Dillon17-Kage/smart-water/docs/README.md

# Docs

Design notes, test records and calibration results for the technical report.
