Dillon17-Kage/smart-water/docs/screenshots/01-login.png

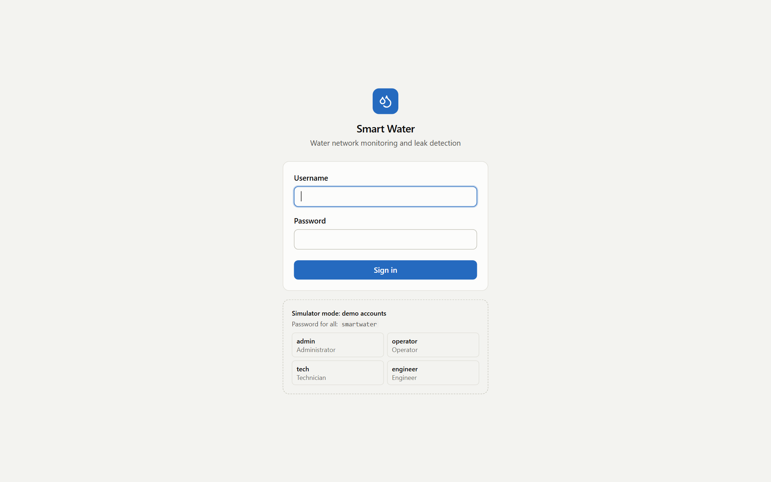
docs/screenshots/01-login.png
