Dillon17-Kage/smart-water/docs/screenshots/03-dashboard-normal.png

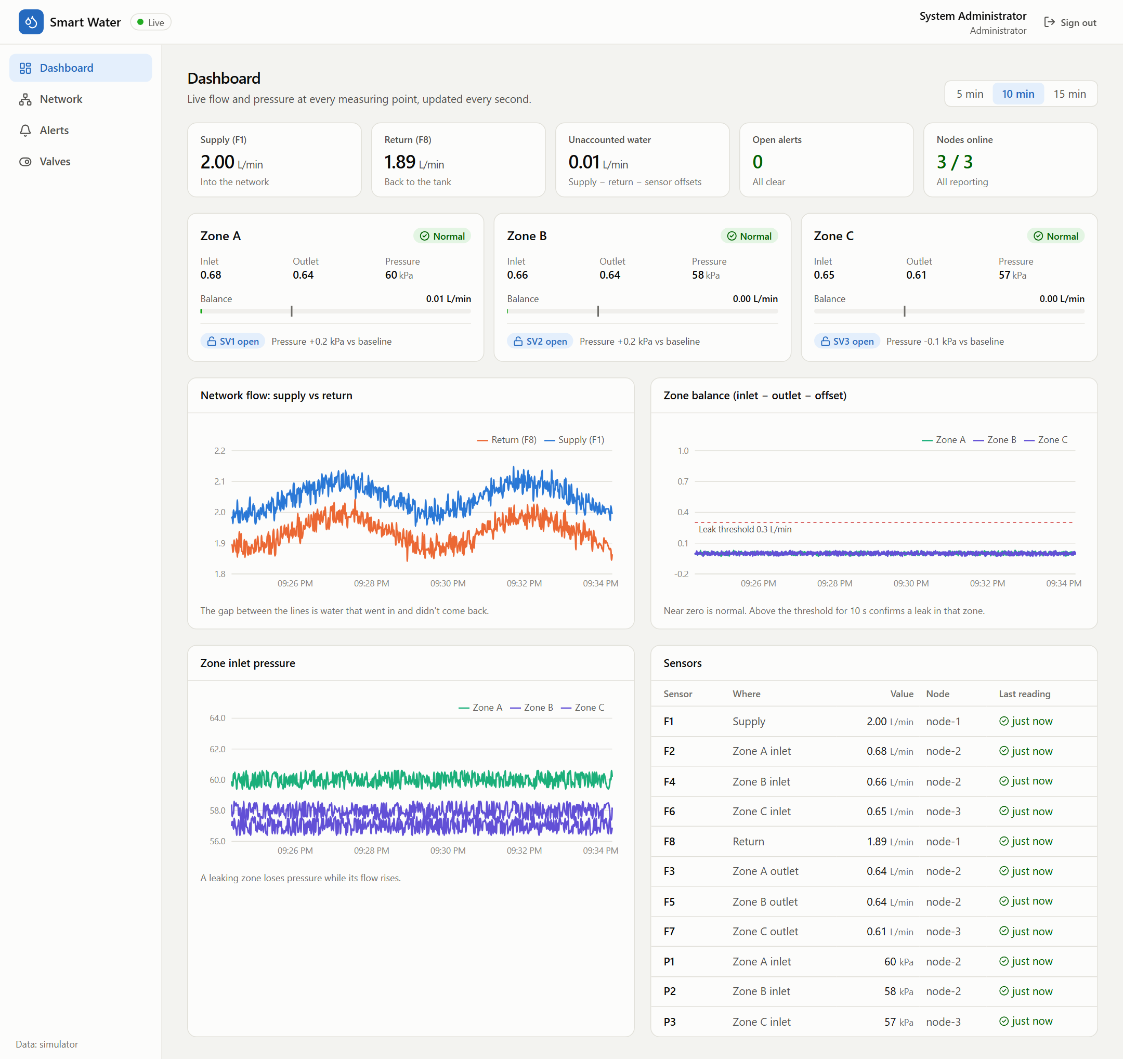
docs/screenshots/03-dashboard-normal.png
