Dillon17-Kage/smart-water/docs/screenshots/05-valves-normal.png

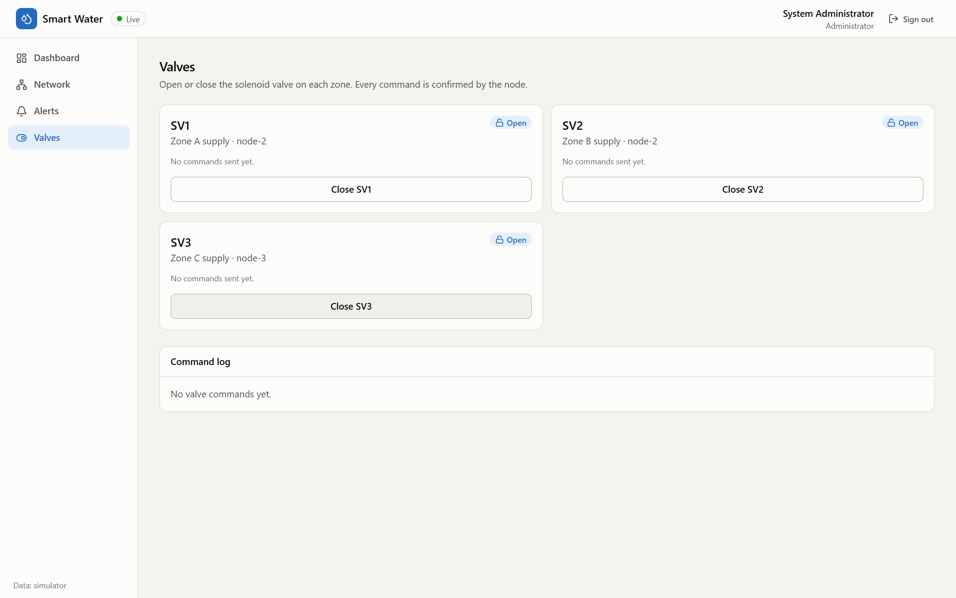
docs/screenshots/05-valves-normal.png
