Dillon17-Kage/smart-water/docs/screenshots/06-alerts-none.png

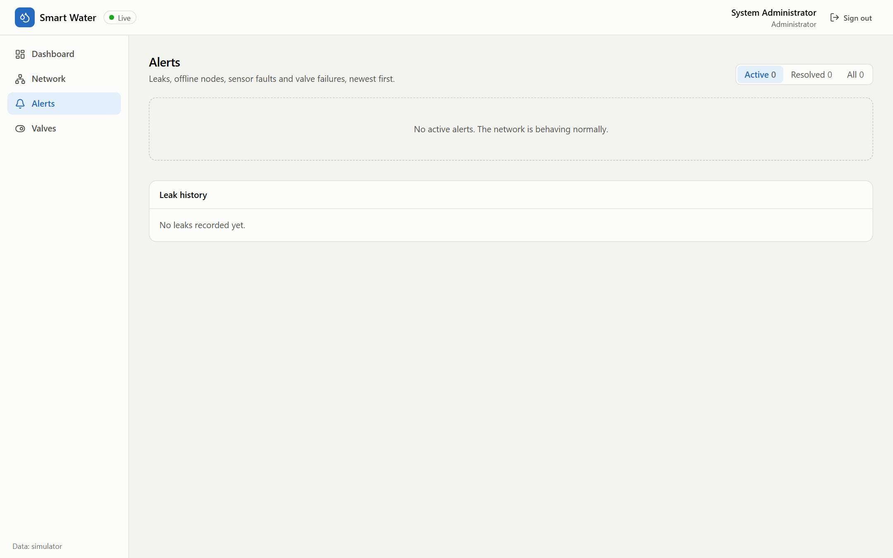
docs/screenshots/06-alerts-none.png
