Dillon17-Kage/smart-water/docs/screenshots/07-dashboard-leak-suspected.png

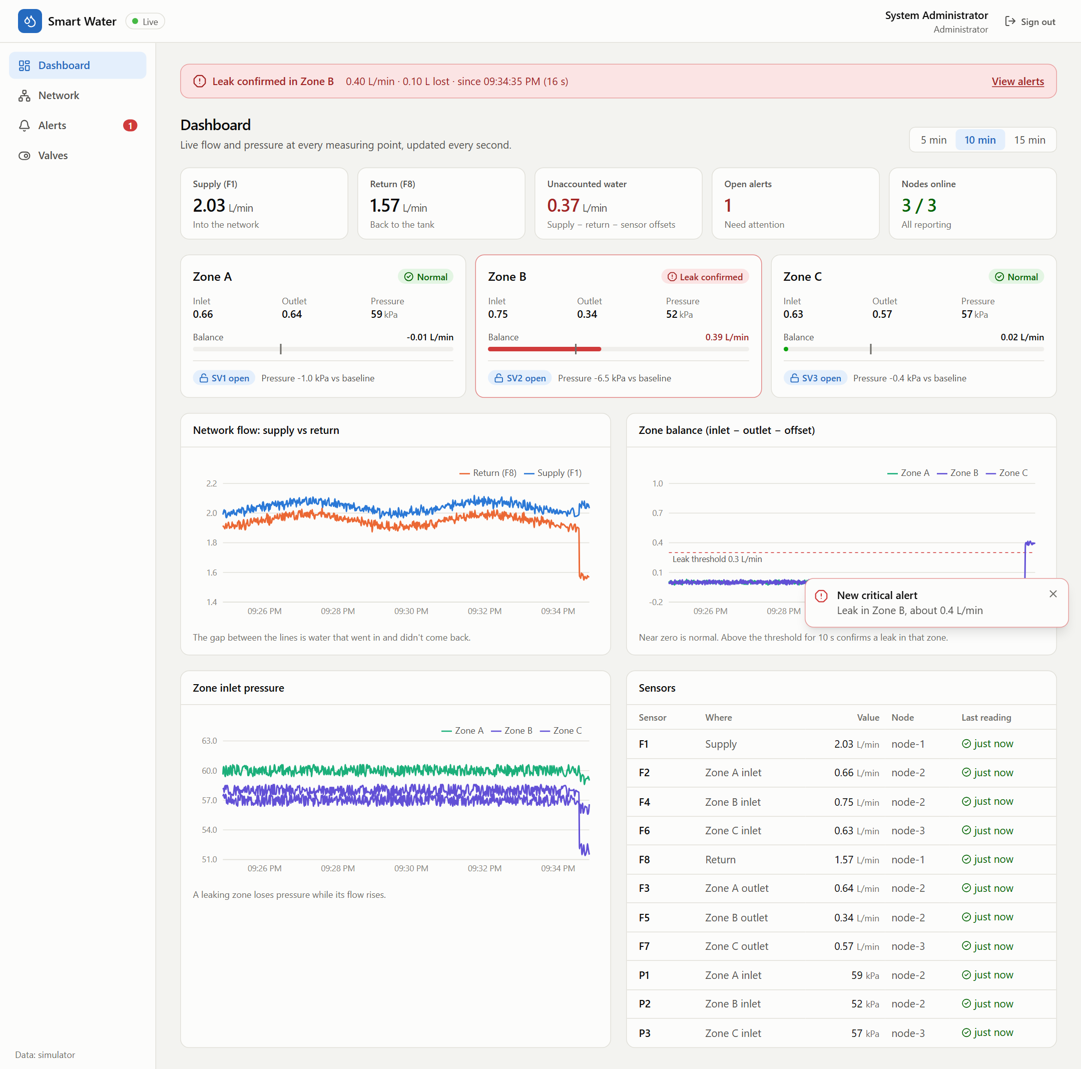
docs/screenshots/07-dashboard-leak-suspected.png
