Dillon17-Kage/smart-water/docs/screenshots/08-dashboard-leak-confirmed.png

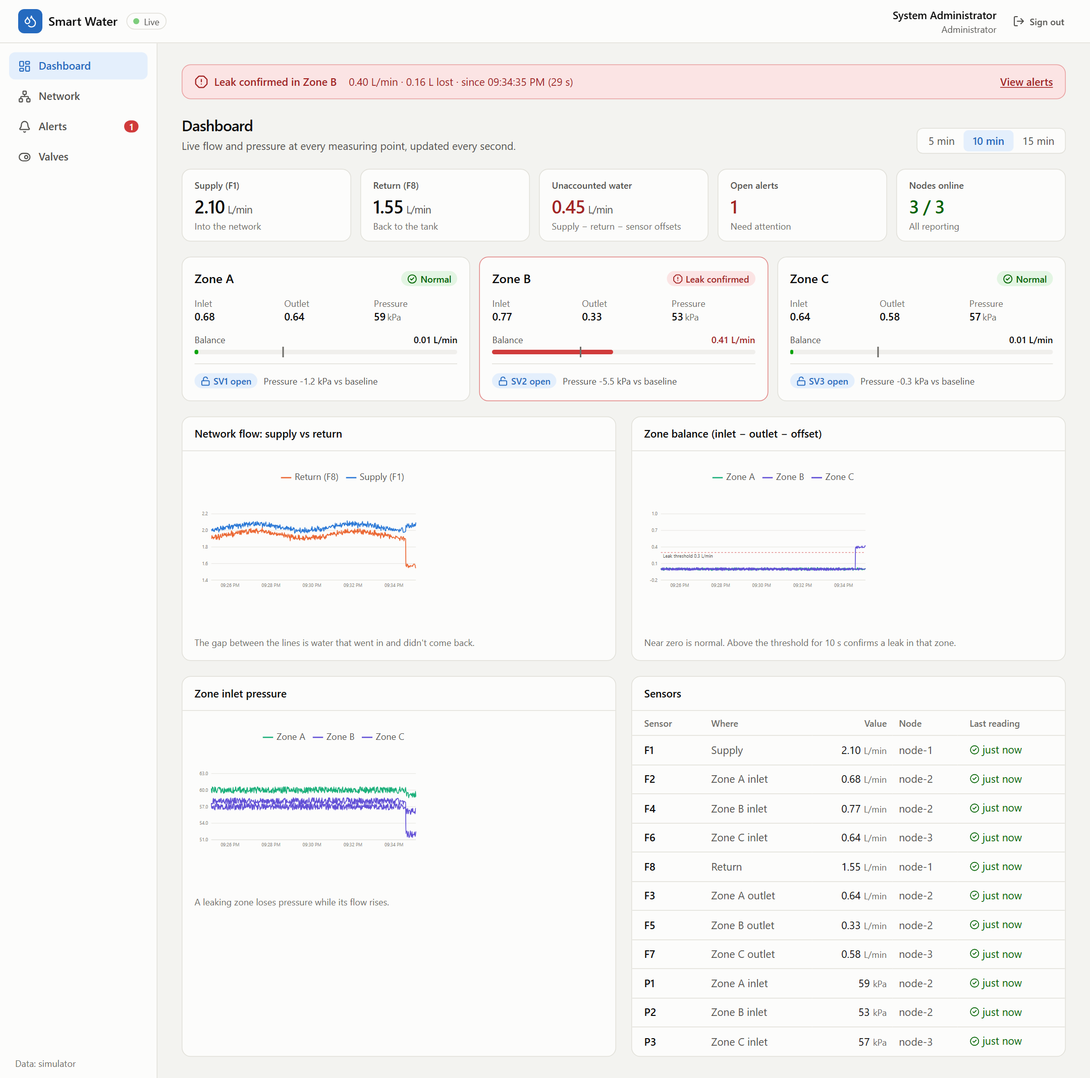
docs/screenshots/08-dashboard-leak-confirmed.png
