Dillon17-Kage/smart-water/docs/screenshots/09-network-leak.png

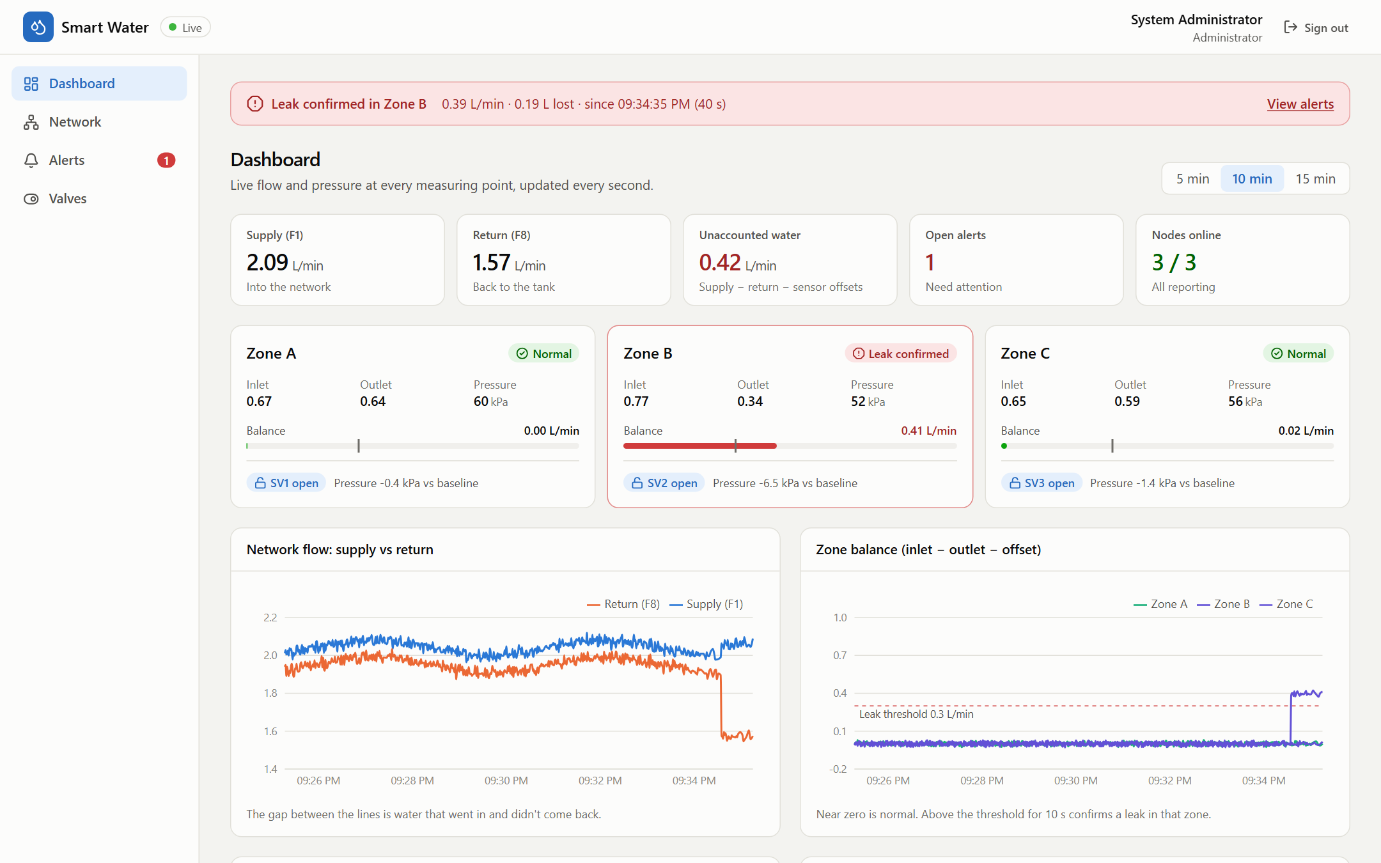
docs/screenshots/09-network-leak.png
