Dillon17-Kage/smart-water/docs/screenshots/10-alerts-leak.png

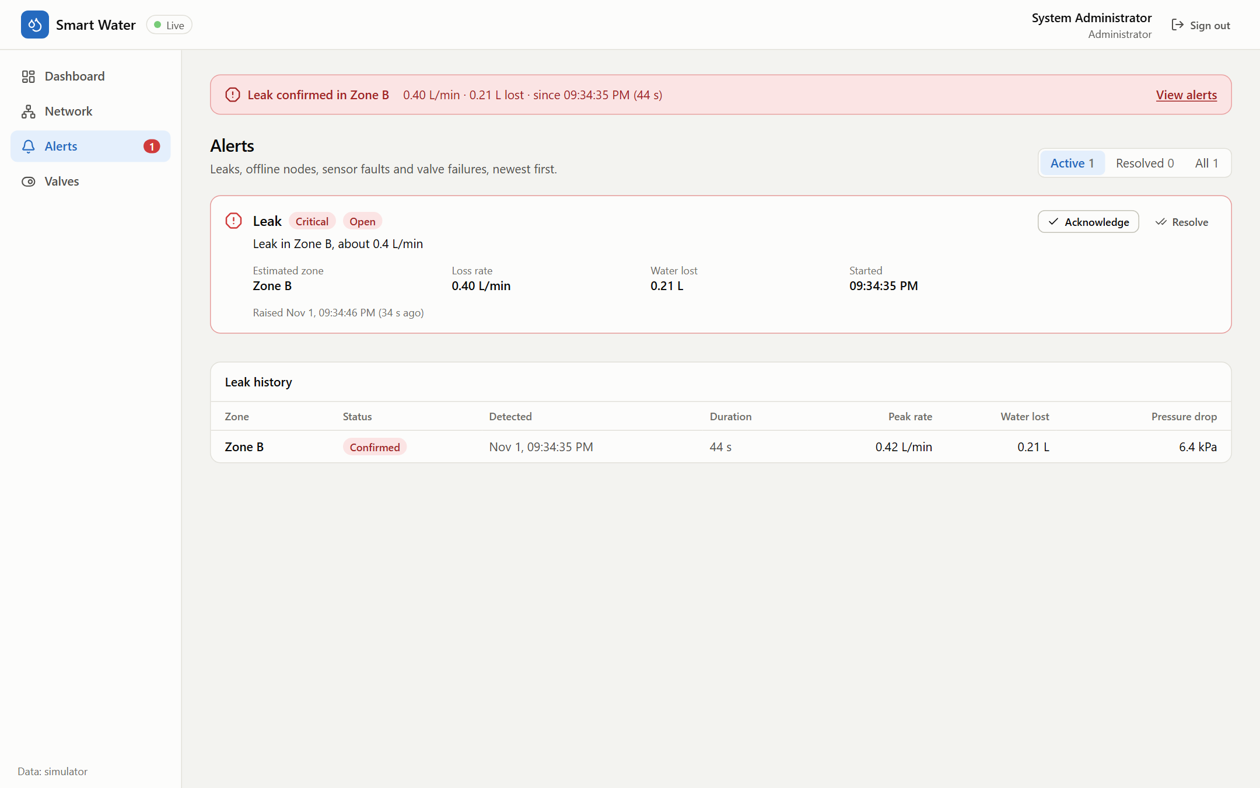
docs/screenshots/10-alerts-leak.png
