Dillon17-Kage/smart-water/docs/screenshots/11-valve-close-dialog.png

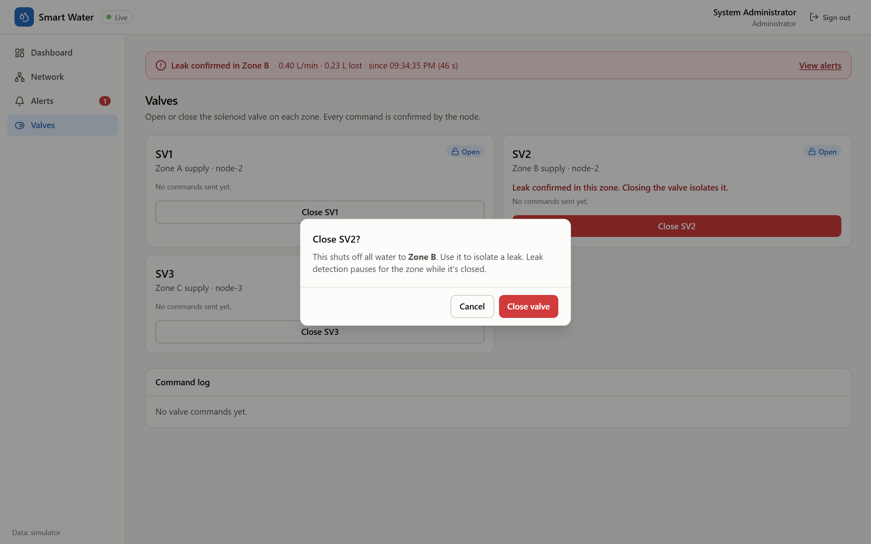
docs/screenshots/11-valve-close-dialog.png
