Dillon17-Kage/smart-water/docs/screenshots/12-valve-close-sent.png

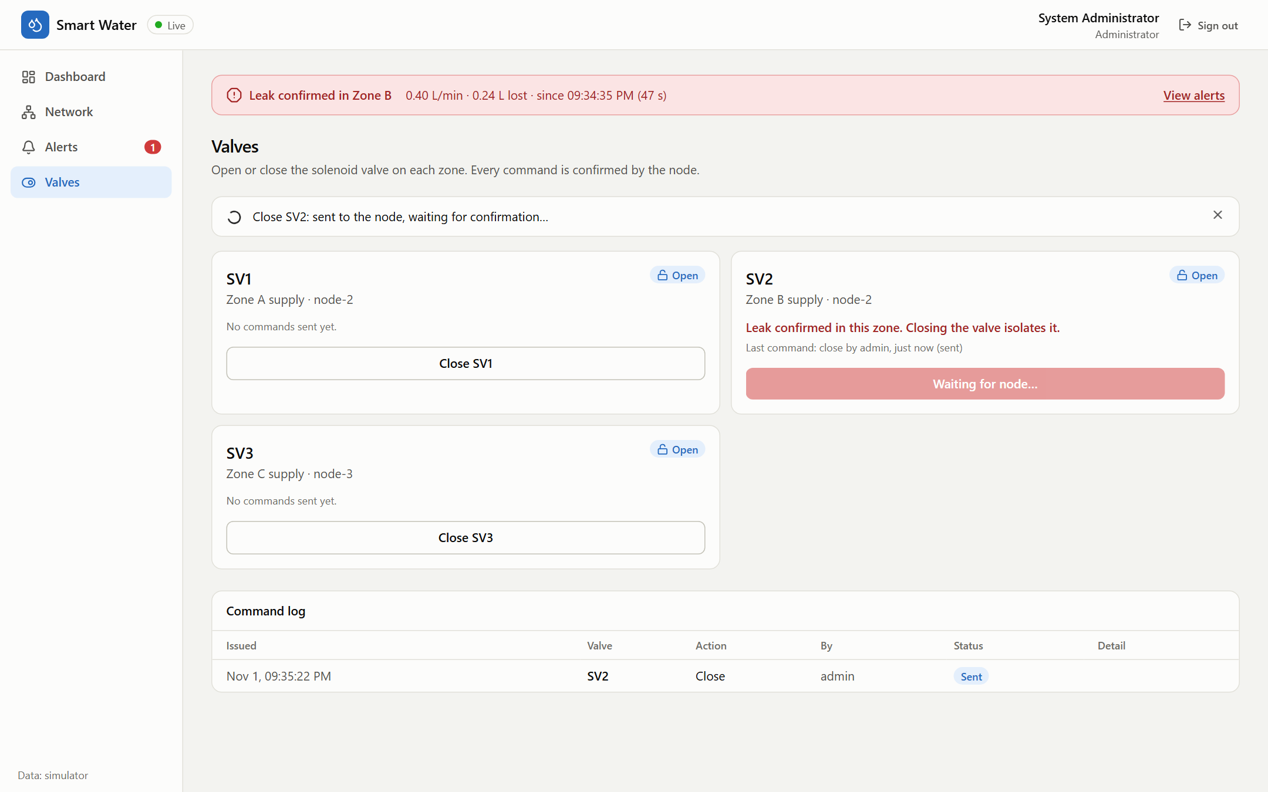
docs/screenshots/12-valve-close-sent.png
