Dillon17-Kage/smart-water/docs/screenshots/13-valve-close-confirmed.png

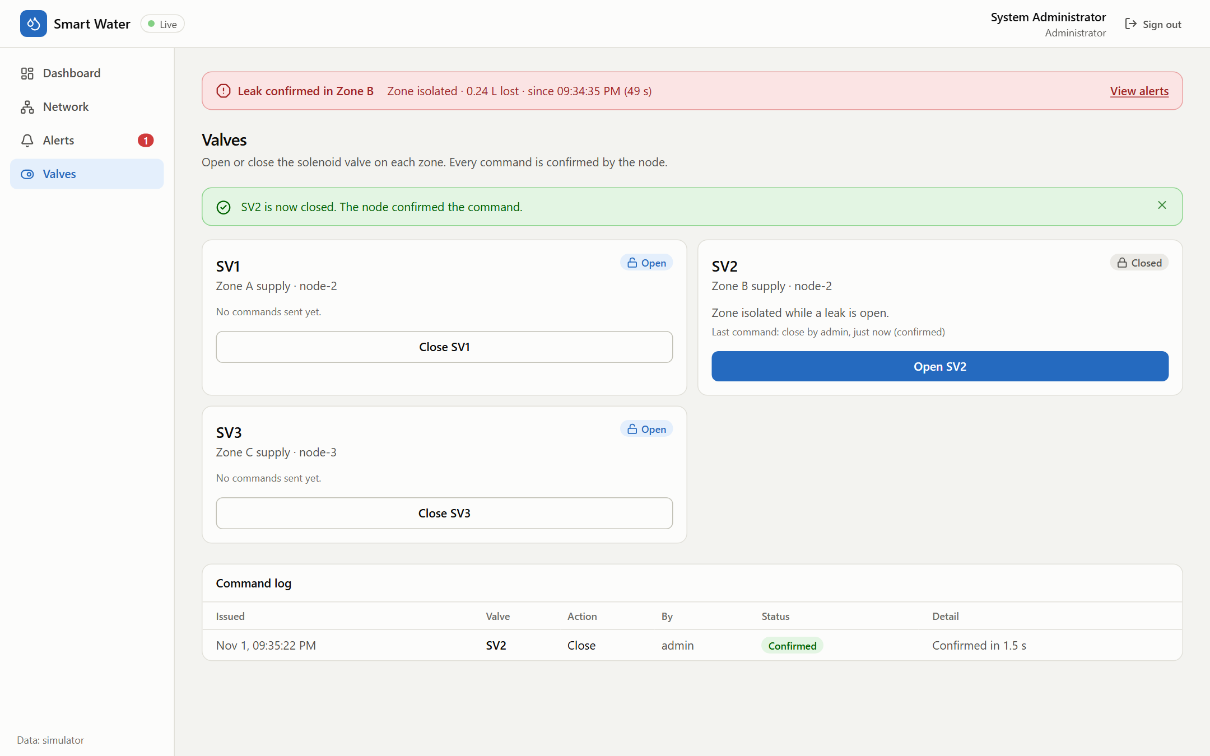
docs/screenshots/13-valve-close-confirmed.png
