Dillon17-Kage/smart-water/docs/screenshots/14-dashboard-zone-isolated.png

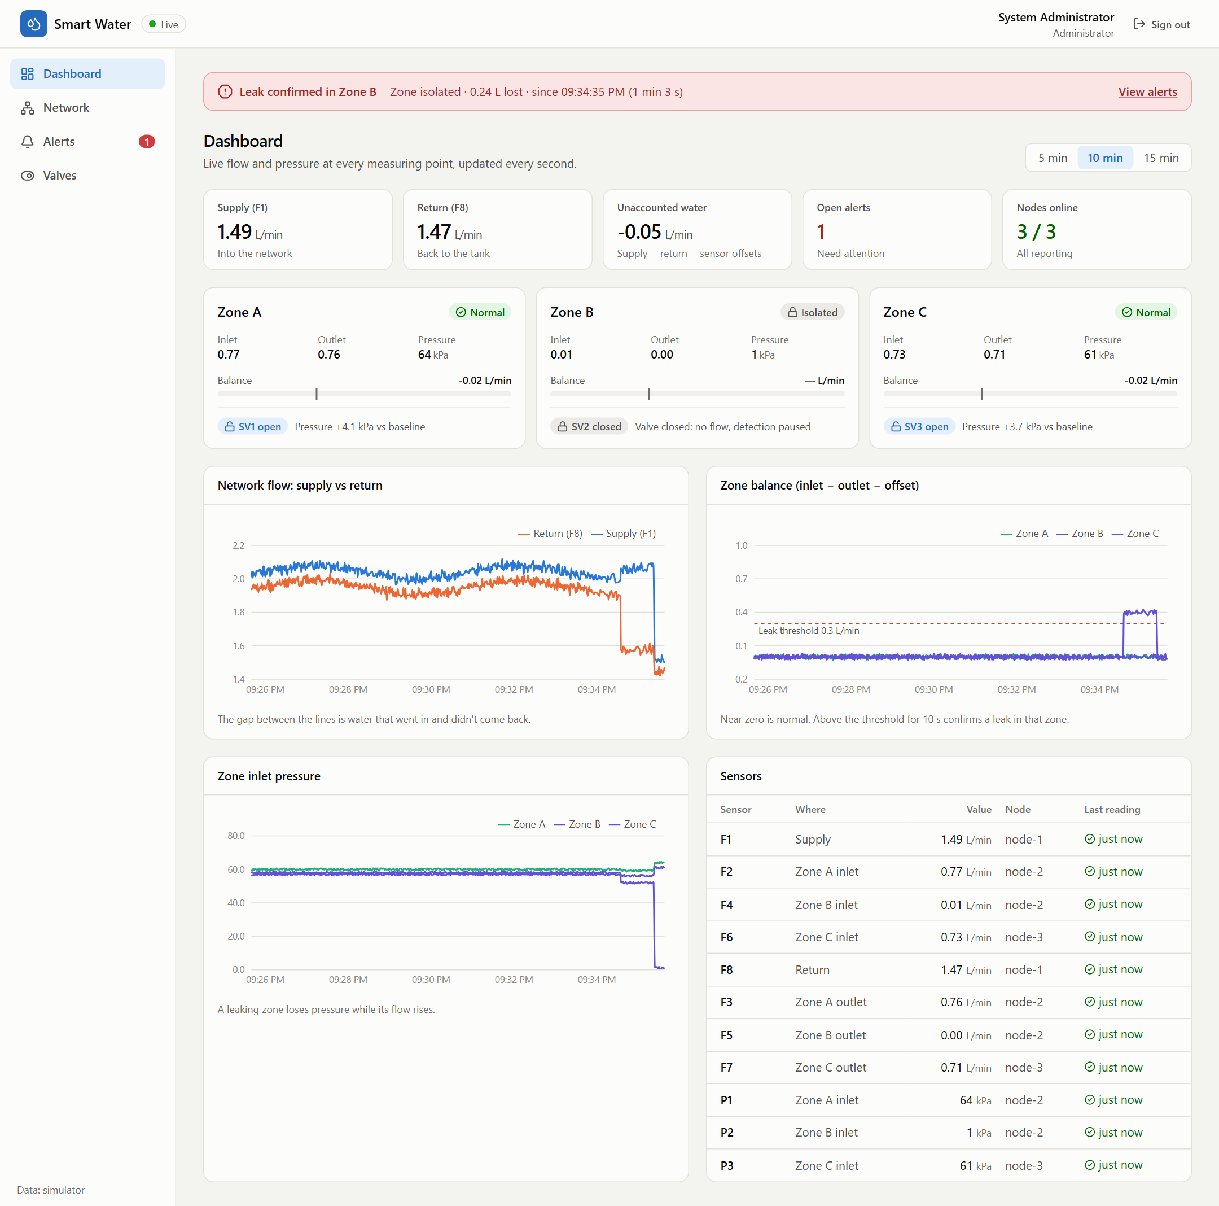
docs/screenshots/14-dashboard-zone-isolated.png
