Dillon17-Kage/smart-water/docs/screenshots/15-network-zone-isolated.png

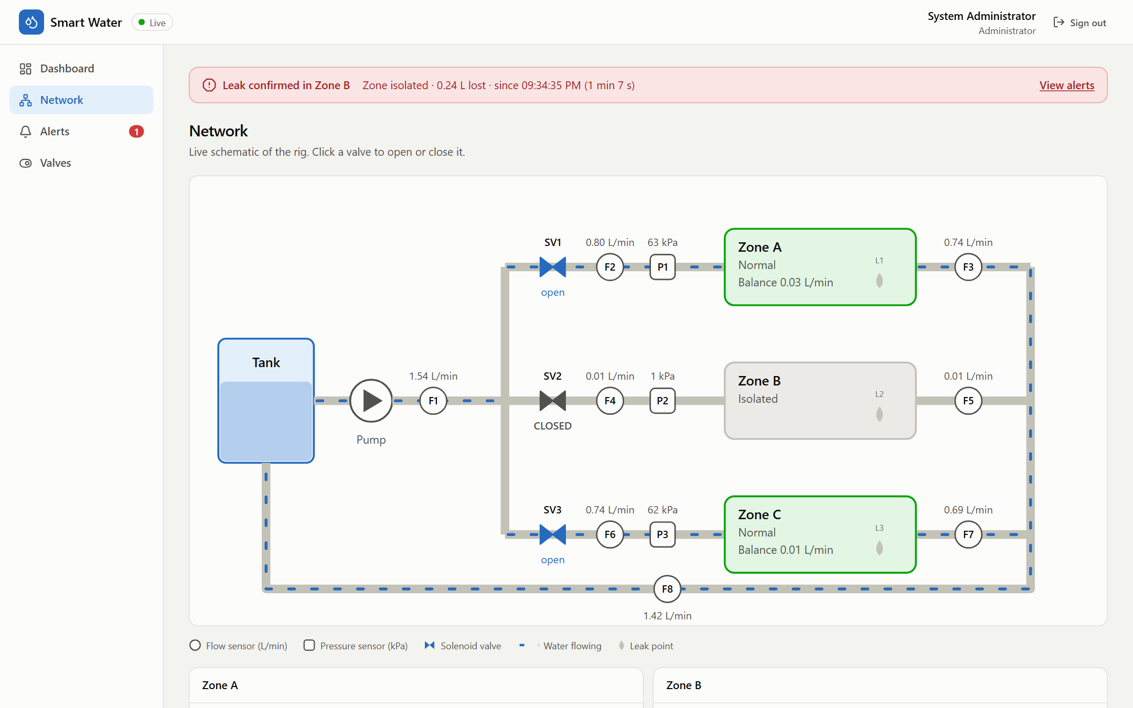
docs/screenshots/15-network-zone-isolated.png
