Dillon17-Kage/smart-water/docs/screenshots/16-alerts-acknowledged.png

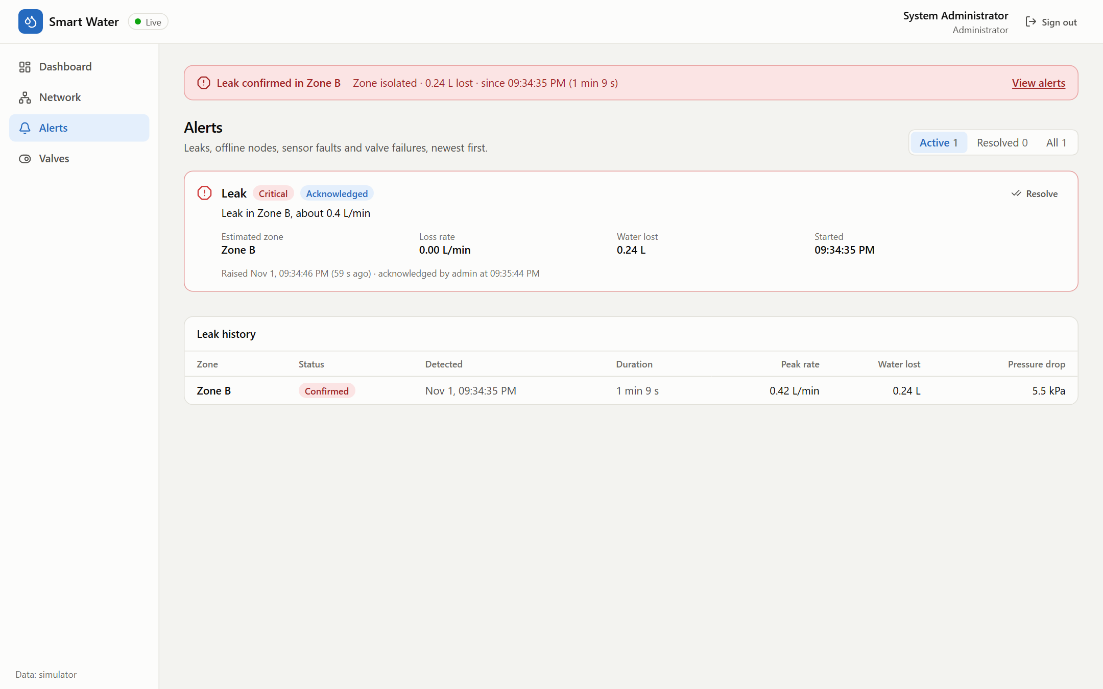
docs/screenshots/16-alerts-acknowledged.png
