Dillon17-Kage/smart-water/docs/screenshots/18-valve-last-zone-pump-off-check.png

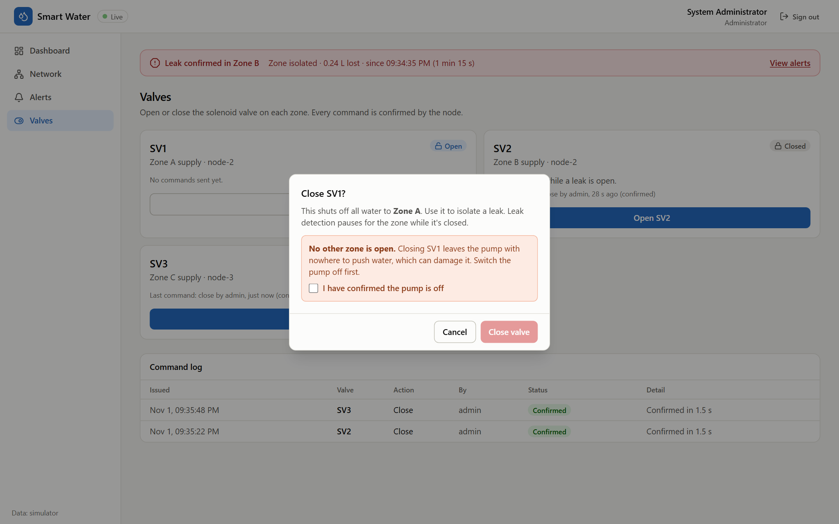
docs/screenshots/18-valve-last-zone-pump-off-check.png
