Dillon17-Kage/smart-water/docs/screenshots/20-dashboard-node-offline.png

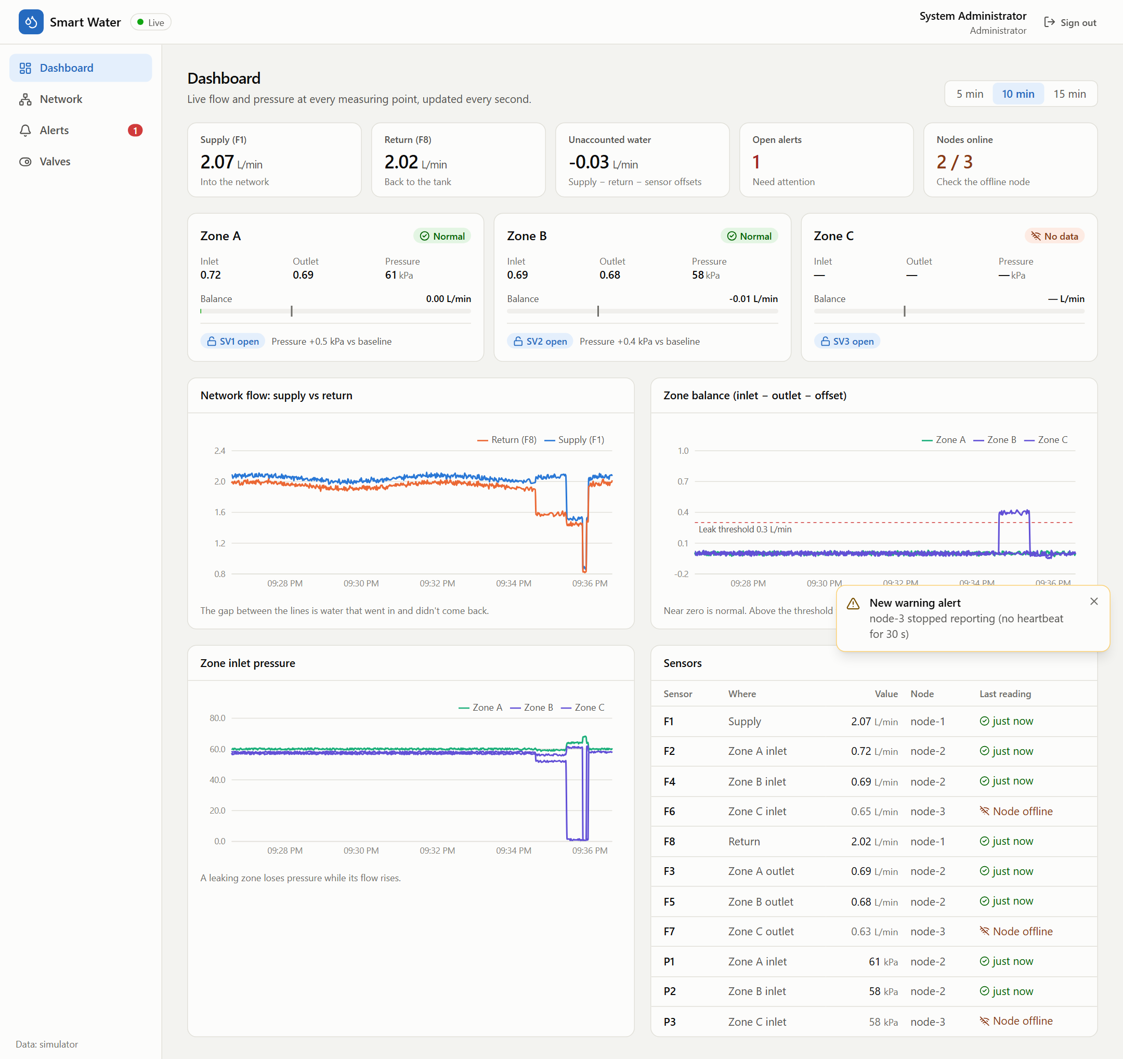
docs/screenshots/20-dashboard-node-offline.png
