Dillon17-Kage/smart-water/docs/screenshots/21-network-node-offline.png

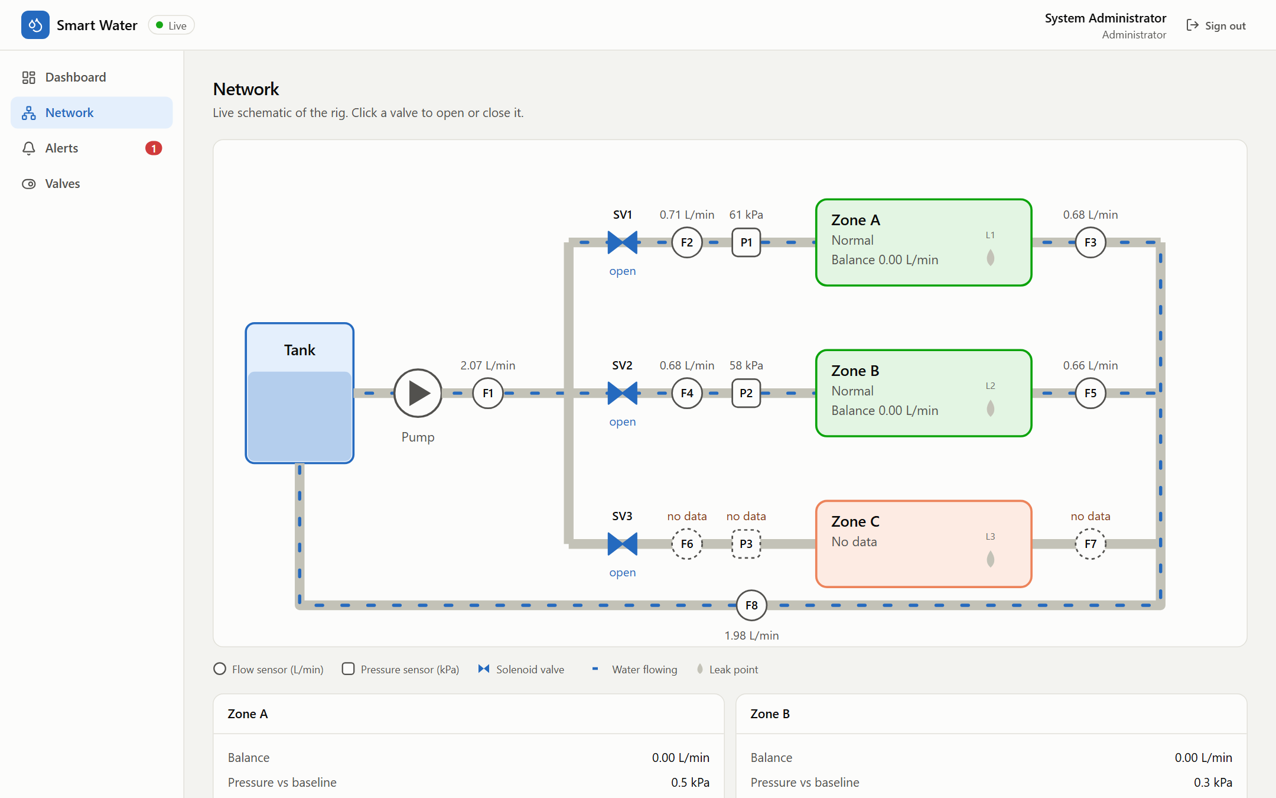
docs/screenshots/21-network-node-offline.png
