Dillon17-Kage/smart-water/docs/screenshots/22-alerts-node-offline.png

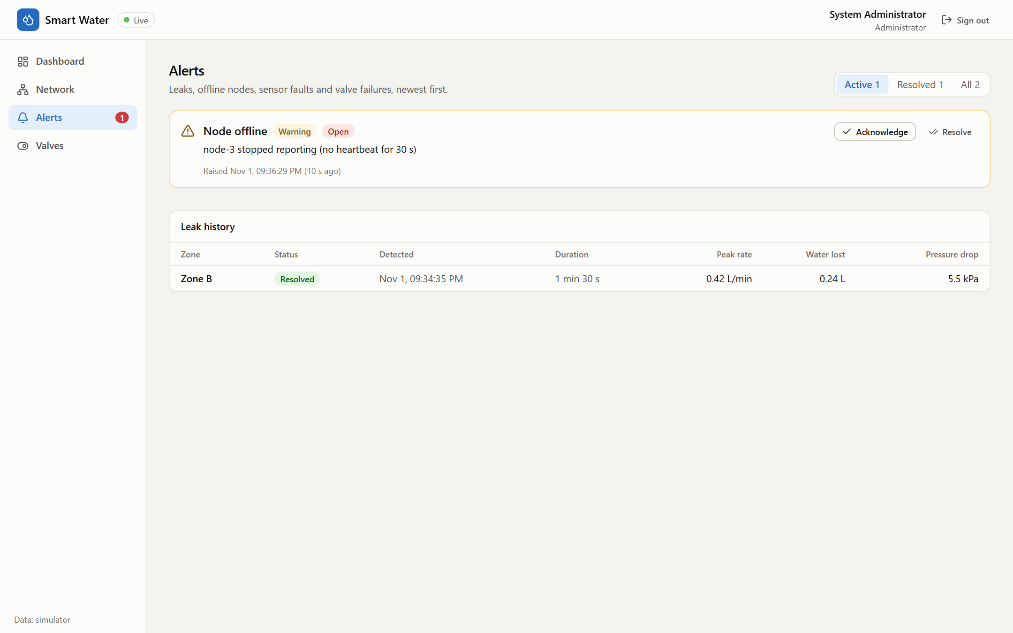
docs/screenshots/22-alerts-node-offline.png
