Dillon17-Kage/smart-water/docs/screenshots/23-dashboard-15-min-chart.png

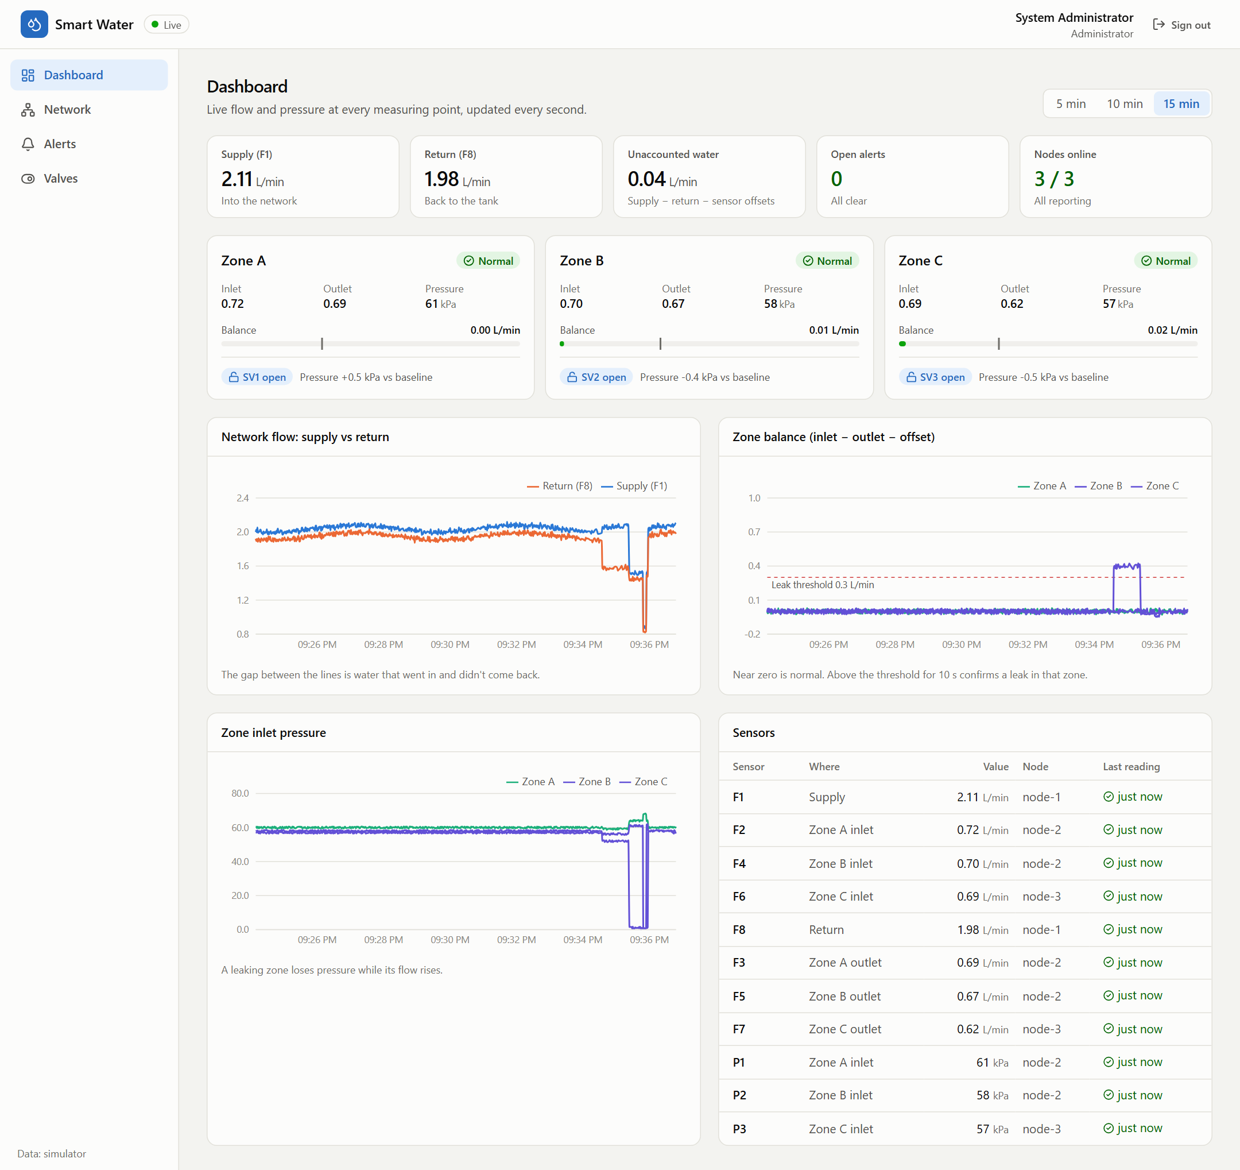
docs/screenshots/23-dashboard-15-min-chart.png
