Dillon17-Kage/smart-water/docs/screenshots/24-valves-technician-read-only.png

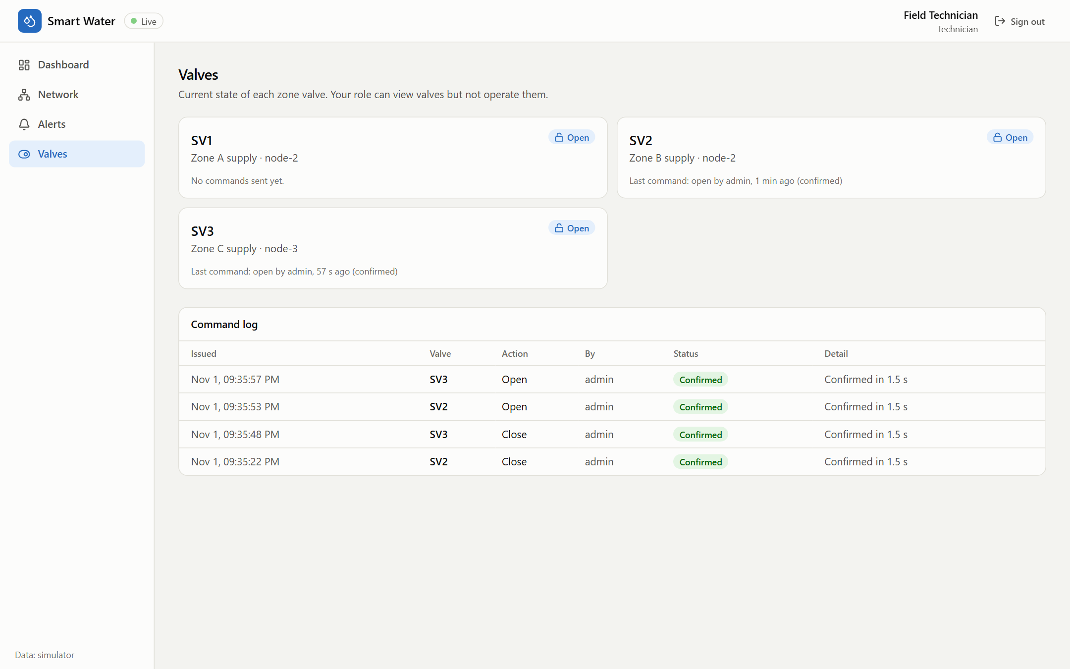
docs/screenshots/24-valves-technician-read-only.png
