Dillon17-Kage/smart-water/docs/screenshots/25-mobile-dashboard.png

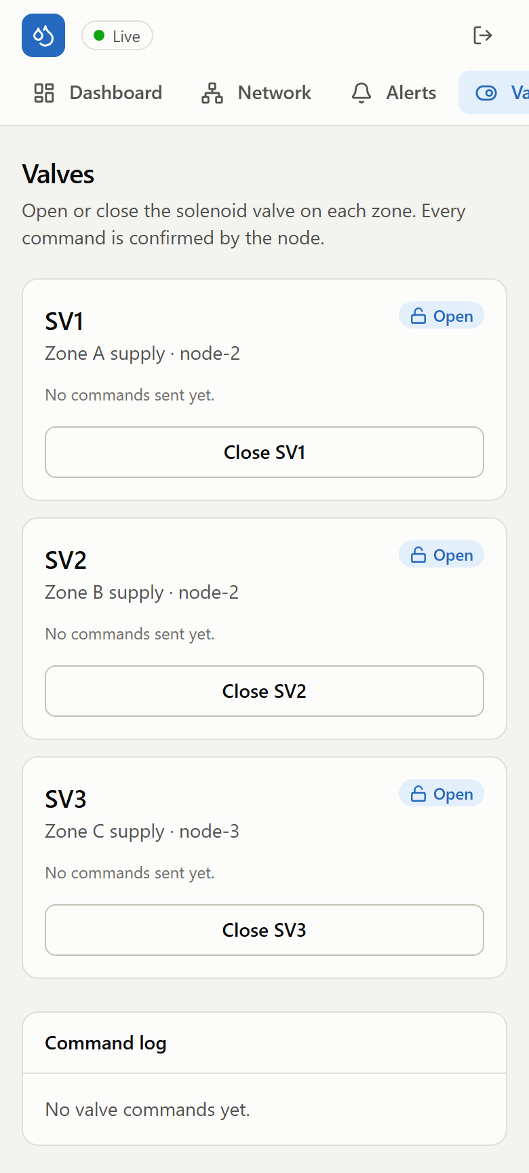
docs/screenshots/25-mobile-dashboard.png
