Dillon17-Kage/smart-water/firmware/node2-schematic.png

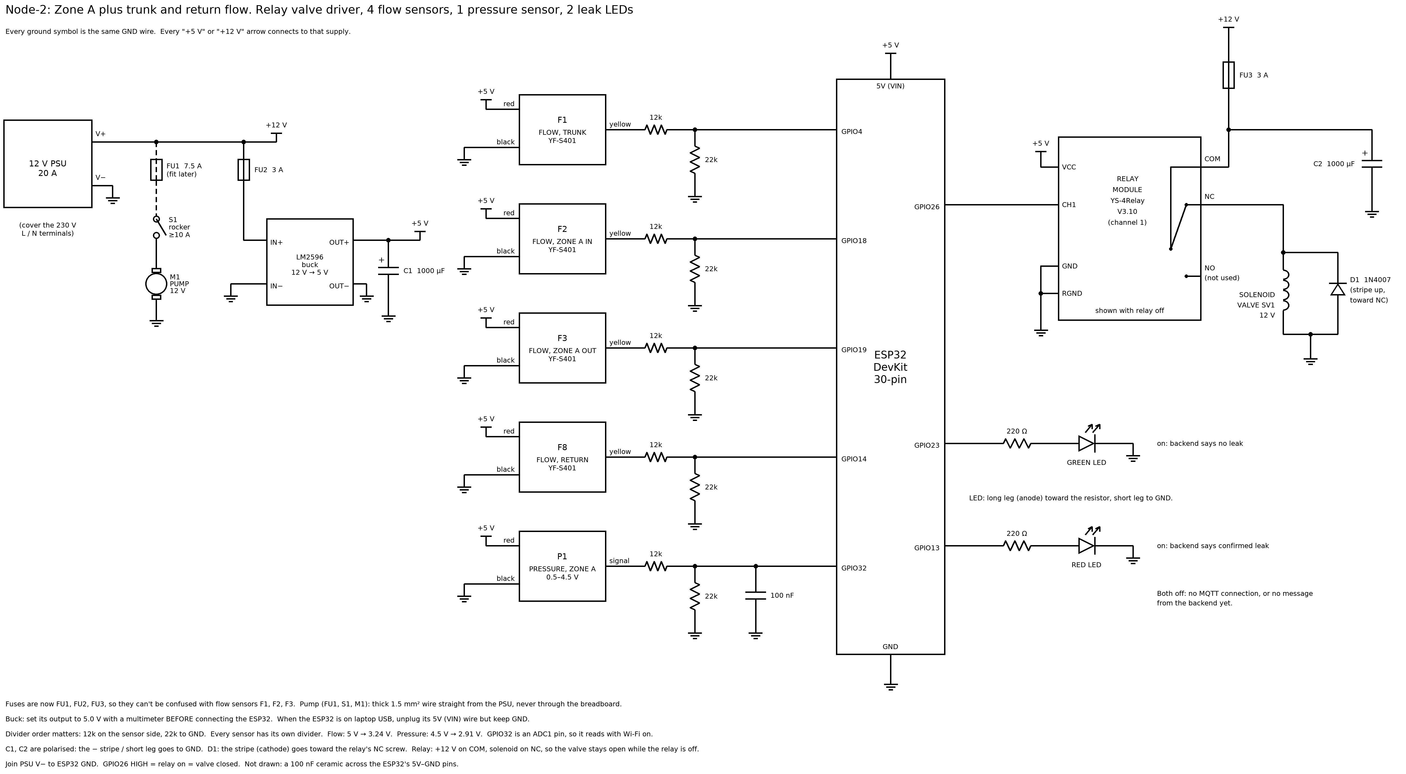
firmware/node2-schematic.png
