Dillon17-Kage/smart-water/firmware/zoneA-schematic-e12.png

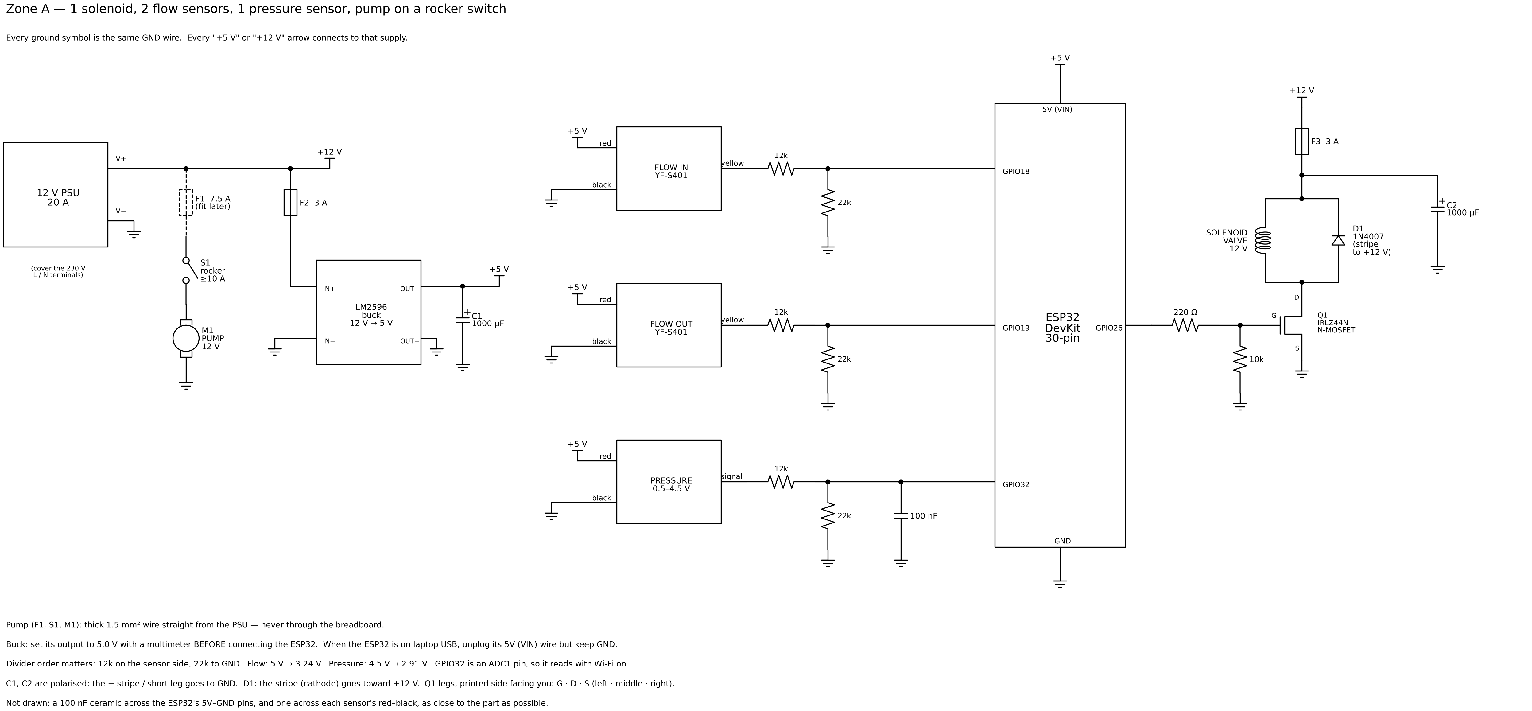
firmware/zoneA-schematic-e12.png
