Dillon17-Kage/smart-water/firmware/zoneA-schematic-relay.png

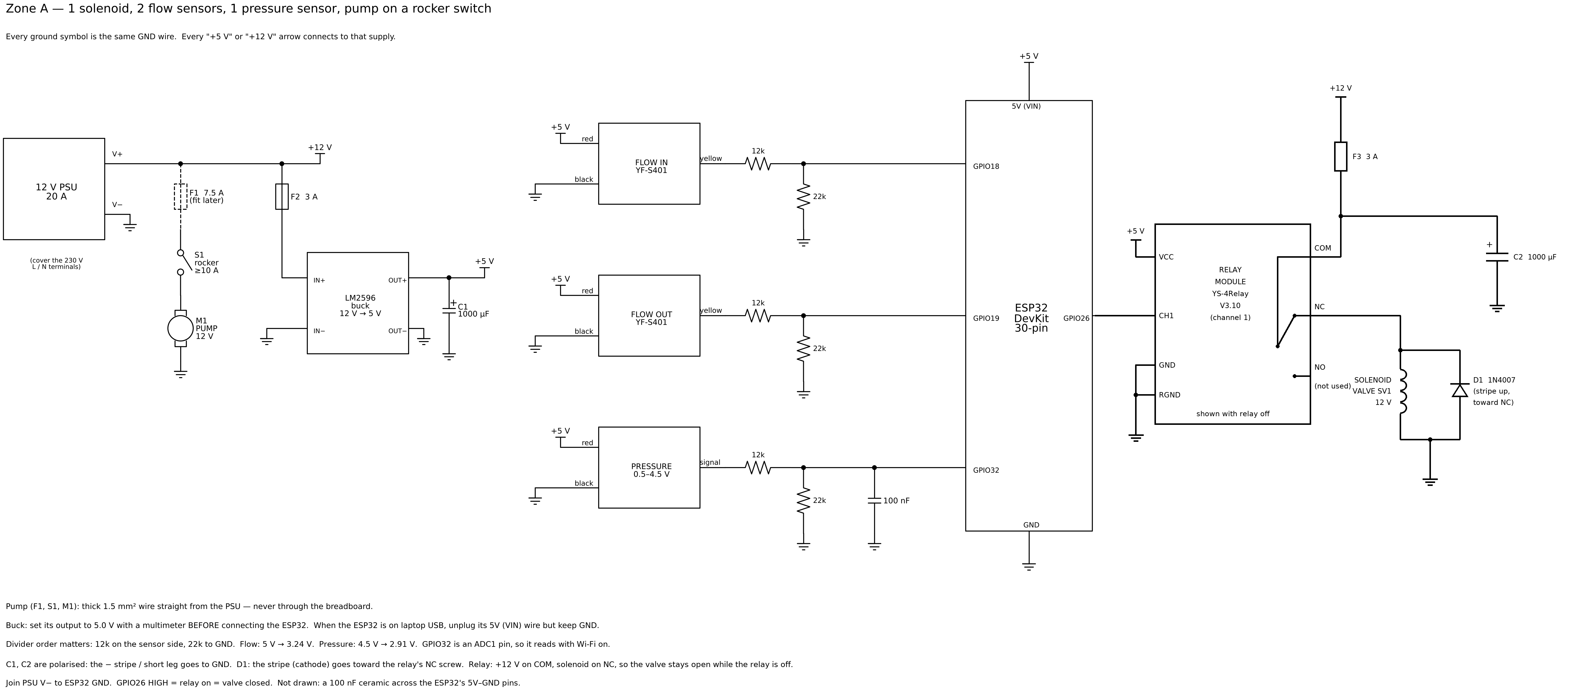
firmware/zoneA-schematic-relay.png
