Dillon17-Kage/smart-water/firmware/node/ca_cert.h

// Root certificate that EMQX Cloud Serverless chains to: DigiCert Global Root G2.
// Public, so it is safe to commit. SHA-1 fingerprint DF:3C:24:F9:BF:D6:66:76:1B:26:80:73:FE:06:D1:CC:8D:4F:82:A4.

#pragma once

const char MQTT_ROOT_CA[] =
"-----BEGIN CERTIFICATE-----\n"
"MIIDjjCCAnagAwIBAgIQAzrx5qcRqaC7KGSxHQn65TANBgkqhkiG9w0BAQsFADBhMQswCQYDVQQG\n"
"EwJVUzEVMBMGA1UEChMMRGlnaUNlcnQgSW5jMRkwFwYDVQQLExB3d3cuZGlnaWNlcnQuY29tMSAw\n"
"HgYDVQQDExdEaWdpQ2VydCBHbG9iYWwgUm9vdCBHMjAeFw0xMzA4MDExMjAwMDBaFw0zODAxMTUx\n"
"MjAwMDBaMGExCzAJBgNVBAYTAlVTMRUwEwYDVQQKEwxEaWdpQ2VydCBJbmMxGTAXBgNVBAsTEHd3\n"
"dy5kaWdpY2VydC5jb20xIDAeBgNVBAMTF0RpZ2lDZXJ0IEdsb2JhbCBSb290IEcyMIIBIjANBgkq\n"
"hkiG9w0BAQEFAAOCAQ8AMIIBCgKCAQEAuzfNNNx7a8myaJCtSnX/RrohCgiN9RlUyfuI2/Ou8jqJ\n"
"kTx65qsGGmvPrC3oXgkkRLpimn7Wo6h+4FR1IAWsULecYxpsMNzaHxmx1x7e/dfgy5SDN67sH0NO\n"
"3Xss0r0upS/kqbitOtSZpLYl6ZtrAGCSYP9PIUkY92eQq2EGnI/yuum06ZIya7XzV+hdG82MHauV\n"
"BJVJ8zUtluNJbd134/tJS7SsVQepj5WztCO7TG1F8PapspUwtP1MVYwnSlcUfIKdzXOS0xZKBgyM\n"
"UNGPHgm+F6HmIcr9g+UQvIOlCsRnKPZzFBQ9RnbDhxSJITRNrw9FDKZJobq7nMWxM4MphQIDAQAB\n"
"o0IwQDAPBgNVHRMBAf8EBTADAQH/MA4GA1UdDwEB/wQEAwIBhjAdBgNVHQ4EFgQUTiJUIBiV5uNu\n"
"5g/6+rkS7QYXjzkwDQYJKoZIhvcNAQELBQADggEBAGBnKJRvDkhj6zHd6mcY1Yl9PMWLSn/pvtsr\n"
"F9+wX3N3KjITOYFnQoQj8kVnNeyIv/iPsGEMNKSuIEyExtv4NeF22d+mQrvHRAiGfzZ0JFrabA0U\n"
"WTW98kndth/Jsw1HKj2ZL7tcu7XUIOGZX1NGFdtom/DzMNU+MeKNhJ7jitralj41E6Vf8PlwUHBH\n"
"QRFXGU7Aj64GxJUTFy8bJZ918rGOmaFvE7FBcf6IKshPECBV1/MUReXgRPTqh5Uykw7+U0b6LJ3/\n"
"iyK5S9kJRaTepLiaWN0bfVKfjllDiIGknibVb63dDcY3fe0Dkhvld1927jyNxF1WW6LZZm6zNTfl\n"
"MrY=\n"
"-----END CERTIFICATE-----\n";
