Dillon17-Kage/smart-water/(commit log)

2026-11-01 Database: match the wiring (F2 18, F6 19, P2 32, SV1 26), interlock on, drop P1/P5
    There is no bypass, so valve.interlock_min_open_zones is 1. Zone B/C and
    node-1 scripts use the pin plan from the hardware brief.
2026-11-01 Add node-2 simulator (tools/simulator)
    .NET console app that publishes readings, status and the last will per
    docs/mqtt-contract.md and answers valve commands with acks, including the
    last-open-valve rejection and duplicate ids. Keys open a leak, switch the
    pump, take the node offline and simulate a valve fault.
2026-11-01 Renumber sensors along the water path (contract v1.1)
    F1 trunk, F2/F3 Zone A in/out, F4/F5 Zone B, F6/F7 Zone C, F8 return,
    P1-P3 at the zone inlets. Zones stay A/B/C, pins are unchanged. Replaces
    the design document's numbering (Zone A was F2/F6/P2). The simulator also
    quits when its piped input ends.
2026-11-01 firmware: serial-only bring-up sketch for node-2 Zone A (F2, F3, P1, SV1)
    Counts F2/F3 flow pulses, reads P1 sensor volts and toggles SV1 over
    serial so the wiring can be checked before the node firmware. Opens SV1
    first thing at boot; closing it needs 'close SV1 force' (pump off).
    Sensor codes follow docs/mqtt-contract.md v1.1.
2026-11-01 firmware: node.ino step 2 - measuring, serial output and valve commands
    Per-node config.h table (node-2 Zone A: F2, F3, P1, SV1; Zone B rows
    ready). One interrupt handler counts pulses for every flow sensor with
    1 ms glitch rejection; pressure is averaged over each 1 s window.
    Opens every valve at boot, refuses to close the last open valve unless
    forced, and builds the readings JSON from docs/mqtt-contract.md v1.1
    (print with 'json'). Serial: open/close, zero P1, cal start/stop,
    status. No network yet. README covers IDE setup and the BOOT+EN upload.
    [config.h, node.ino]
2026-11-01 Switch MQTT broker from HiveMQ to EMQX Cloud Serverless (contract v1.2)
    HiveMQ Cloud Serverless no longer accepts new clusters and retires on
    31 Dec 2026. Only the connection section of the contract changes.
2026-11-01 Backend Phase 3: MQTT ingestion, node heartbeat, leak detection, alerts, valve control, login, SignalR
    - Readings are checked, converted with the sensors table's calibration and stored;
    bad data goes to rejected_readings
    - Nodes go offline on the last will or 30 s of silence (node_offline alerts)
    - Per-zone mass balance: suspected -> confirmed (critical alert) -> resolved
    - Valve commands: node-online and interlock gates (force after pump-off confirm),
    ack handling, 5 s timeout with a valve_failure alert
    - JWT login with BCrypt and lockout; all endpoints from apiSource.ts; /hubs/live
    - Calibration: zone baseline over 60 s, pressure zero
    - tools/dbsetup adduser creates logins without pass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
2026-11-01 firmware: sensor dividers are 12k/22k (E12) instead of 10k/20k
    Divider ratio is now computed from the two resistor values in both
    sketches (34/22 = 1.545), so the pressure mV sent is still the sensor
    voltage. 5 V in gives 3.24 V at the pin.
2026-11-01 firmware: Zone A schematic copy with E12 divider values (12k / 22k)
2026-11-01 firmware: flatten E12 schematic onto a white background
    The transparent background rendered black in dark-mode viewers.
2026-11-01 firmware: drive SV1 through a relay module (NC contact, fail-open)
    The fitted IRFZ44N can't be switched from 3.3 V, so SV1 now goes
    through a YS-4Relay module (on when CH1 is HIGH) with the solenoid on
    the relay's NC contact. New per-valve ValveDriver setting: GPIO LOW
    powers the coil, so the valve stays open if the ESP32 resets.
    RESULTS.md and README updated.
    [bringup.ino, config.h, node.ino]
2026-11-01 Web app: pump-off confirm (force) for closing the last open valve; interlock on in the simulator
    The valve dialog checks the interlock like the backend does. When a close would
    leave no zone open it asks the operator to confirm the pump is off and sends
    force = true. Tested against the backend: login, rig, readings, SignalR pushes,
    close refused without force, confirmed with force, reopen.
2026-11-04 firmware: Zone A schematic with the relay module driving SV1
2026-11-04 firmware: add Wi-Fi, MQTT over TLS, NTP, status, valve commands and acks
    Implements docs/mqtt-contract.md v1.2 against EMQX Serverless. Also
    records the Zone A water test in RESULTS.md.
2026-11-04 firmware: record first EMQX connection test and P1 pressure estimate
2026-11-04 Backend: publish a retained leak indicator to each node (contract v1.3)
    The leak decision is made in the backend, so a node can't drive its red and
    green LEDs by itself. Publish smartwater/{node}/indicator when a confirmed leak
    starts or ends, when the backend connects to the broker and when a node comes
    online. The simulator subscribes too and prints what it receives.
2026-11-04 firmware: leak indicator LEDs driven by the backend over MQTT
    [config.h, node.ino]
2026-11-05 Move F1 and F8 to node-2 (contract v1.4)
    The rig as built has the trunk and return flow sensors on node-2 with Zone A, on
    GPIO 4 and 14, and no node-1. Update the contract, the database script and the
    simulator to match. Also correct the pressure divider to 12k/22k in the contract.
2026-11-05 Set P1's measured zero of 0.38 V
    The value is provisional until it is measured on the final 5 V supply. The -20 kPa
    limit stays, so a disconnected P1 at the ADC floor is rejected.
2026-11-05 Web app: calibration page for the flow baseline and pressure zero
    The backend endpoints existed with no way to reach them. Administrators and
    technicians can now run both, and the backend refuses when a sensor isn't sending.
2026-11-10 One board per zone: node-3 for Zone B, node-4 for Zone C (contract v1.5)
    Each node now has one valve, so its own last-open-valve check would refuse every
    close. The backend decides with its rig-wide interlock and sends force: true for
    every close it allows. A close still waiting for its ack counts as closed, so two
    closes at once can't both pass. The simulator takes --Zone=B or C, and the web
    app's simulator follows the same layout.
2026-11-10 node-4 is an ESP32-C3: Zone C pins F6 5, F7 6, P3 3, SV3 7
    LEDs on GPIO 10 and 4. The script still isn't applied until the board exists.
2026-11-10 firmware: one sketch for node-2, node-3 (Zone B) and node-4 (Zone C, ESP32-C3)
    THIS_NODE in config.h picks the node name, pin tables and EMQX login.
    node-4 uses ESP32-C3 SuperMini pins. Help text uses the board's own
    valve and pressure codes. Adds the full node-2 schematic.
2026-11-10 Keep unwired flow sensors switched off
    Unwired flow pins read about 1 L/min of noise, and the difference between a zone's
    two pins can look like a leak. F4 and F5 are off until Zone B is wired, and the
    Zone C script adds F6 and F7 switched off.
2026-11-10 Keep every flow sensor switched on
    The user wants to test each zone straight after wiring it. Zone C's script adds F6
    and F7 switched on again; flow_sensors_unwired.sql stays as an option.
2026-11-10 firmware: lower Wi-Fi transmit power on the ESP32-C3 so node-4 can join
    The C3 SuperMini's antenna is badly matched and at full power it never
    finishes joining the network. 8.5 dBm connects at -48 dBm from the hotspot.
